tbreckle/blast/pcb/blast/blast.kicad_pcb

## KiCad design pcb/blast/blast.kicad_pcb (2026-02-01)

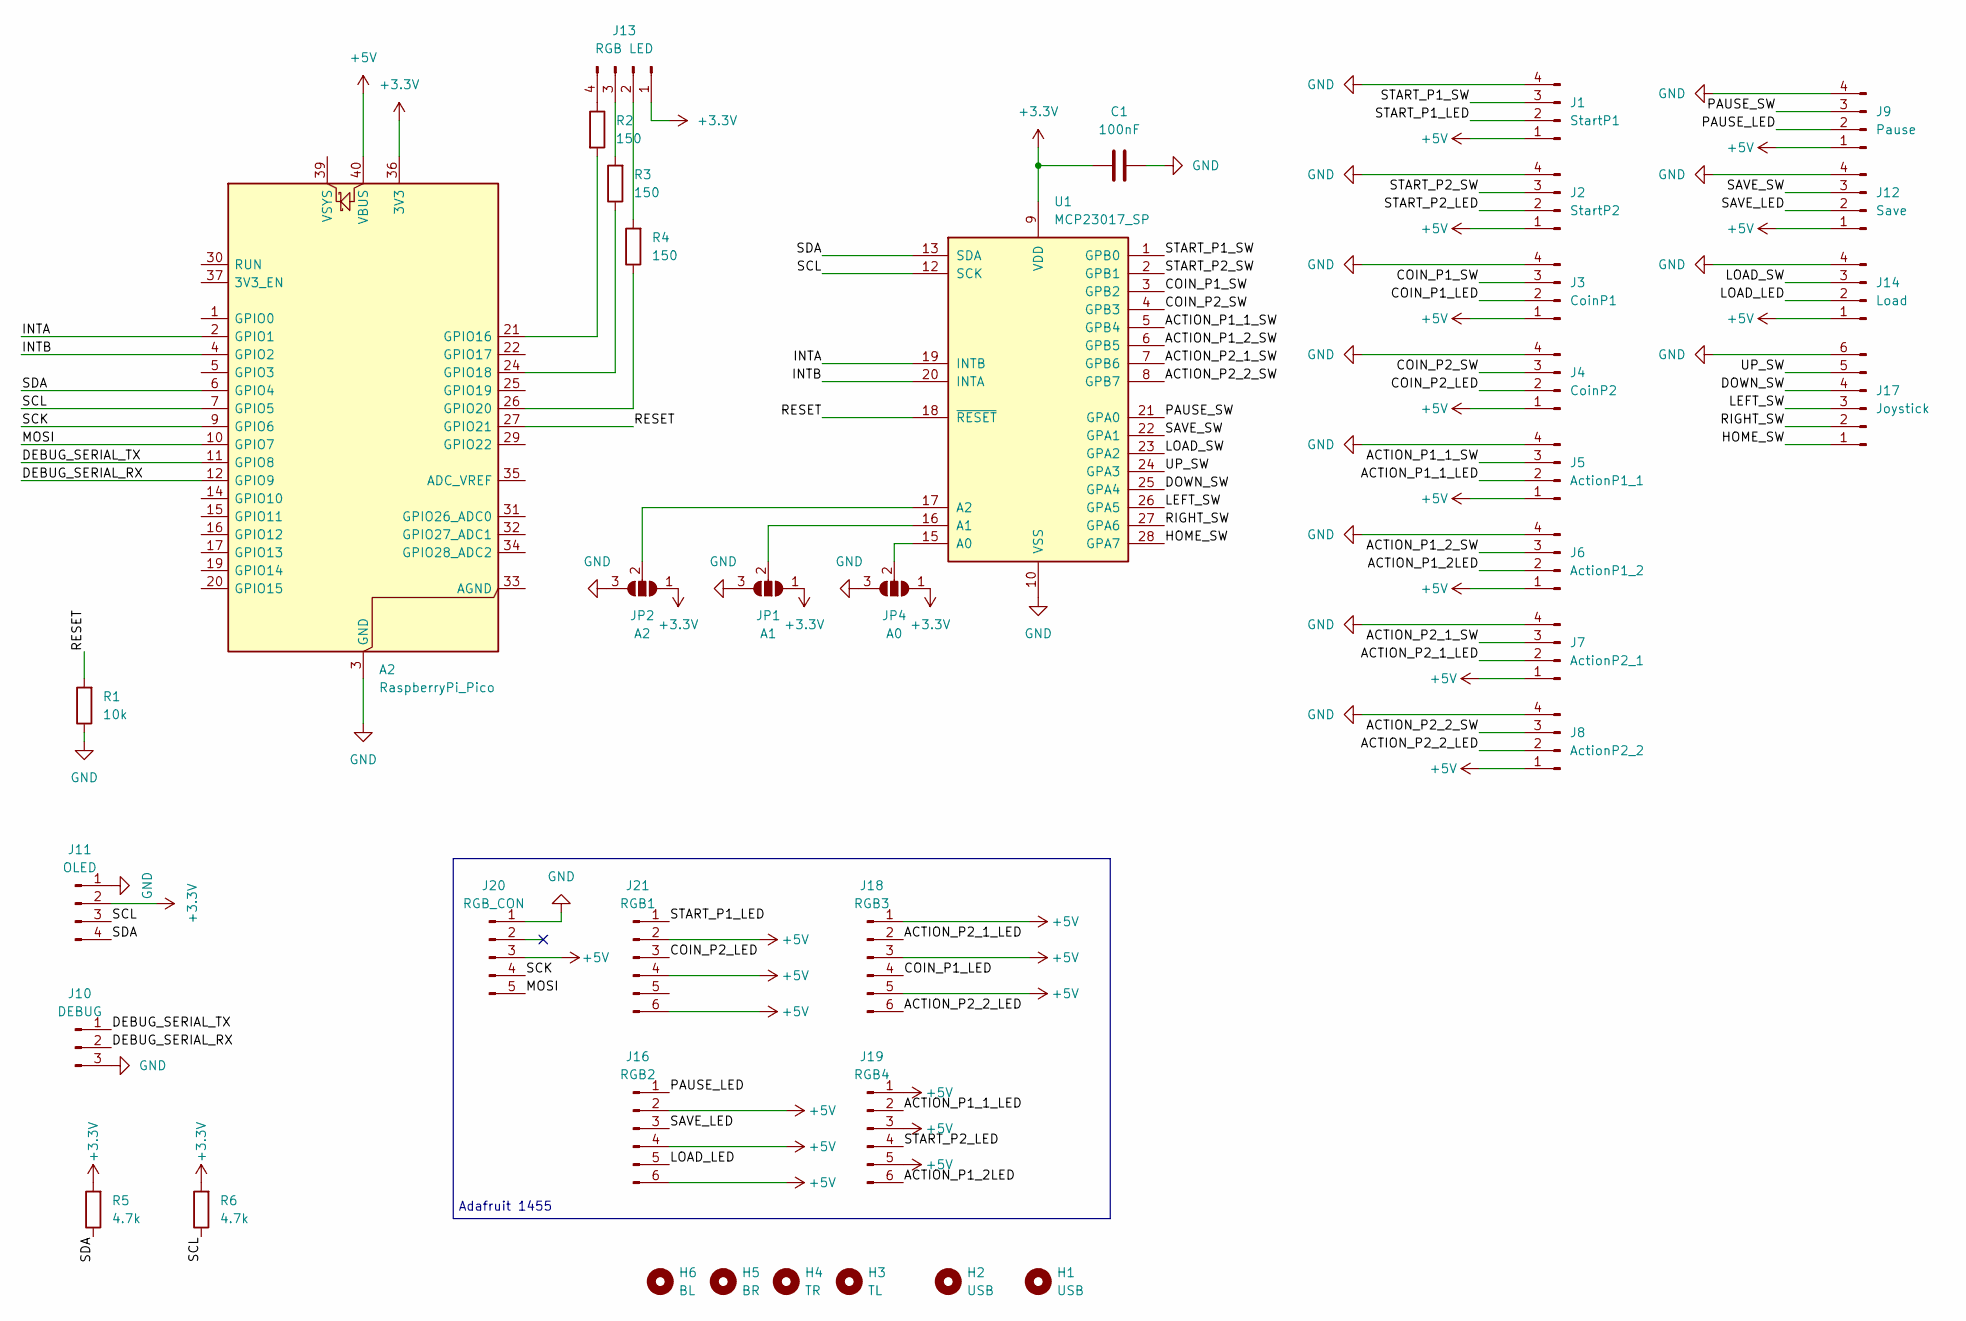
[picture p2: schematic blast.kicad_sch, B.L.A.S.T. Board]

Parts:
A2: RaspberryPi_Pico; RaspberryPi_Pico_Common_Unspecified
C1: 100nF; C_1206_3216Metric_Pad1.33x1.80mm_HandSolder
H1, H2: USB; MountingHole_4.3mm_M4
H3: TL; MountingHole_3.2mm_M3
H4: TR; MountingHole_3.2mm_M3
H5: BR; MountingHole_3.2mm_M3
H6: BL; MountingHole_3.2mm_M3
J1: StartP1; JST_XH_B4B-XH-A_1x04_P2.50mm_Vertical
J2: StartP2; JST_XH_B4B-XH-A_1x04_P2.50mm_Vertical
J3: CoinP1; JST_XH_B4B-XH-A_1x04_P2.50mm_Vertical
J4: CoinP2; JST_XH_B4B-XH-A_1x04_P2.50mm_Vertical
J5: ActionP1_1; JST_XH_B4B-XH-A_1x04_P2.50mm_Vertical
J6: ActionP1_2; JST_XH_B4B-XH-A_1x04_P2.50mm_Vertical
J7: ActionP2_1; JST_XH_B4B-XH-A_1x04_P2.50mm_Vertical
J8: ActionP2_2; JST_XH_B4B-XH-A_1x04_P2.50mm_Vertical
J9: Pause; JST_XH_B4B-XH-A_1x04_P2.50mm_Vertical
J10: DEBUG; PinSocket_1x03_P2.54mm_Vertical
J11: OLED; JST_XH_B4B-XH-A_1x04_P2.50mm_Vertical
J12: Save; JST_XH_B4B-XH-A_1x04_P2.50mm_Vertical
J13: RGB LED; JST_XH_B4B-XH-A_1x04_P2.50mm_Vertical
J14: Load; JST_XH_B4B-XH-A_1x04_P2.50mm_Vertical
J16: RGB2; PinSocket_2x03_P2.54mm_Vertical
J17: Joystick; JST_XH_B6B-XH-A_1x06_P2.50mm_Vertical
J18: RGB3; PinSocket_2x03_P2.54mm_Vertical
J19: RGB4; PinSocket_2x03_P2.54mm_Vertical
J20: RGB_CON; PinSocket_1x05_P2.54mm_Vertical
J21: RGB1; PinSocket_2x03_P2.54mm_Vertical
JP1: A1; SolderJumper-3_P1.3mm_Open_RoundedPad1.0x1.5mm_NumberLabels
JP2: A2; SolderJumper-3_P1.3mm_Open_RoundedPad1.0x1.5mm_NumberLabels
JP4: A0; SolderJumper-3_P1.3mm_Open_RoundedPad1.0x1.5mm_NumberLabels
R1: 10k; R_1206_3216Metric_Pad1.30x1.75mm_HandSolder
R2, R3, R4: 150; R_1206_3216Metric_Pad1.30x1.75mm_HandSolder
R5, R6: 4.7k; R_1206_3216Metric_Pad1.30x1.75mm_HandSolder
U1: MCP23017_SP; DIP-28_W7.62mm

Connections:
+3.3V: A2.36 (3V3), C1.1, J11.2, J13.1, JP1.1 (A), JP2.1 (A), JP4.1 (A), R5.2, R6.2, U1.9 (VDD)
+5V: A2.40 (VBUS), J1.1, J2.1, J3.1, J4.1, J5.1, J6.1, J7.1, J8.1, J9.1, J12.1, J14.1, J16.2, J16.4, J16.6, J18.1, J18.3, J18.5, J19.1, J19.3, J19.5, J20.3, J21.2, J21.4, J21.6
/ACTION_P1_1_LED: J5.2, J19.2
/ACTION_P1_1_SW: J5.3, U1.5 (GPB4)
/ACTION_P1_2LED: J6.2, J19.6
/ACTION_P1_2_SW: J6.3, U1.6 (GPB5)
/ACTION_P2_1_LED: J7.2, J18.2
/ACTION_P2_1_SW: J7.3, U1.7 (GPB6)
/ACTION_P2_2_LED: J8.2, J18.6
/ACTION_P2_2_SW: J8.3, U1.8 (GPB7)
/COIN_P1_LED: J3.2, J18.4
/COIN_P1_SW: J3.3, U1.3 (GPB2)
/COIN_P2_LED: J4.2, J21.3
/COIN_P2_SW: J4.3, U1.4 (GPB3)
/DEBUG_SERIAL_RX: A2.12 (GPIO9), J10.2
/DEBUG_SERIAL_TX: A2.11 (GPIO8), J10.1
/DOWN_SW: J17.4, U1.25 (GPA4)
/HOME_SW: J17.1, U1.28 (GPA7)
/INTA: A2.2 (GPIO1), U1.19 (INTB)
/INTB: A2.4 (GPIO2), U1.20 (INTA)
/LEFT_SW: J17.3, U1.26 (GPA5)
/LOAD_LED: J14.2, J16.5
/LOAD_SW: J14.3, U1.23 (GPA2)
/MOSI: A2.10 (GPIO7), J20.5
/PAUSE_LED: J9.2, J16.1
/PAUSE_SW: J9.3, U1.21 (GPA0)
/RESET: A2.27 (GPIO21), R1.2, U1.18 (~RESET)
/RIGHT_SW: J17.2, U1.27 (GPA6)
/SAVE_LED: J12.2, J16.3
/SAVE_SW: J12.3, U1.22 (GPA1)
/SCK: A2.9 (GPIO6), J20.4
/SCL: A2.7 (GPIO5), J11.3, R6.1, U1.12 (SCK)
/SDA: A2.6 (GPIO4), J11.4, R5.1, U1.13 (SDA)
/START_P1_LED: J1.2, J21.1
/START_P1_SW: J1.3, U1.1 (GPB0)
/START_P2_LED: J2.2, J19.4
/START_P2_SW: J2.3, U1.2 (GPB1)
/UP_SW: J17.5, U1.24 (GPA3)
GND: A2.3 (GND), A2.8 (GND), A2.13 (GND), A2.18 (GND), A2.23 (GND), A2.28 (GND), A2.38 (GND), C1.2, J1.4, J2.4, J3.4, J4.4, J5.4, J6.4, J7.4, J8.4, J9.4, J10.3, J11.1, J12.4, J14.4, J17.6, J20.1, JP1.3 (B), JP2.3 (B), JP4.3 (B), R1.1, U1.10 (VSS)
unnamed: A2.21 (GPIO16), R2.2
unnamed: A2.24 (GPIO18), R3.1
unnamed: A2.26 (GPIO20), R4.1
unnamed: J13.2, R4.2
unnamed: J13.3, R3.2
unnamed: J13.4, R2.1
unnamed: JP1.2 (C), U1.16 (A1)
unnamed: JP2.2 (C), U1.17 (A2)
unnamed: JP4.2 (C), U1.15 (A0)

Notes on the sheet:
Adafruit 1455

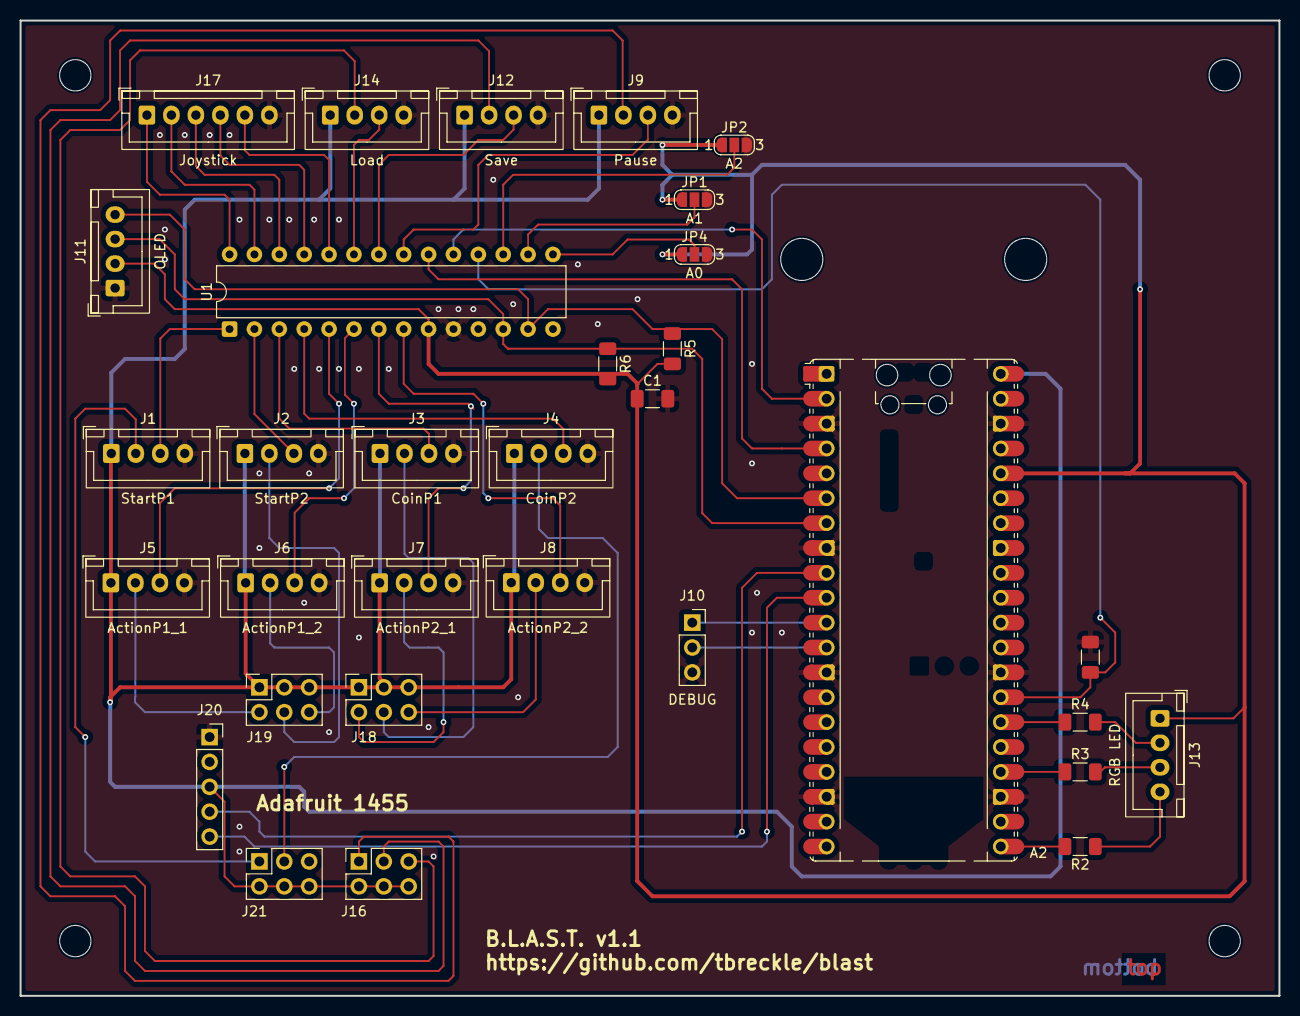
[picture p3: board blast.kicad_pcb from above]

Board: 2 copper layers, 128.5 x 99.6 mm, 38 parts (0 on the bottom side), 48 nets.
