tbreckle/blast/(commit log)

2026-02-07 Initialize and properly run all hardware. Some bugfixes.
    [firmware.ino, menu.cpp, menu.h, serializer.cpp, storage.cpp, storage.h]
2026-03-26 Fix keypress missing bug, fix service menu display.
    [debounce_mcp.cpp, debounce_mcp.h, firmware.ino, menu.cpp]
2026-03-27 Fix some bugs on Windows with the app.
    [menu.cpp]
2026-03-31 Fix buttonpresses detection and support holding buttons.
    [debounce_mcp.cpp, debounce_mcp.h, firmware.ino, menu.h]
2026-09-23 Adds game name profile switching and BLAST protocol docs.
    Firmware:
    - Add gameName[30] (MAMEHooker game name) to ButtonMapping (now 79 bytes).
    - Add BLAST command BLx<GAMENAME>: switch to the first profile whose
    gameName matches exactly; ignored if no profile matches.
    - Store a profile layout version in the last EEPROM byte and migrate
    version 1 profiles (49 bytes) at boot, keeping names and key mappings.
    - Add activateProfile(), used by the menu and BL. It applies profile LEDs
    immediately and now updates currentProfileIndex, so "Back" in the
    profile menu returns to the active profile instead of slot 0.
    - B1/B2 turn off all LEDs and cancel running flash sequences.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
2026-09-24 Sets green led in SLIP mode, fixes service menu buttons, adds BLx blast protocol with empty game name.
    [blast_protocol.cpp, firmware.ino, menu.cpp, menu.h]
2026-09-24 Switches app from egui to Slint.
2026-09-24 Improves USB device identification.
2026-09-26 Fixes A/B button LED assignement. Improves build pipelines.
    [blast_protocol.cpp, firmware.ino, menu.h, serializer.cpp]
2026-10-10 Adds wrap around to the device menu.
